SoaresCarlos/LCT_CARLOS/README.md

Laboratorio de Controle de Temperatura Portatil. Aqui encontram-se todos os codigos elaborados durante o desenvolvimento do projeto
