SoaresCarlos/LCT_CARLOS/Testes Experimentais/Testes_Only_python/Entrada Unitaria_900s.csv

Tempo (s) | PWM | Temperatura (ºC)
1.8605201244354248 | 127 | nan
2.9188530445098877 | 127 | 33.57771260997067
4.012604475021362 | 127 | 33.57771260997067
5.0719499588012695 | 127 | 33.57771260997067
6.132680177688599 | 127 | 33.57771260997067
7.197888135910034 | 127 | 33.57771260997067
8.24724006652832 | 127 | 33.57771260997067
9.29603362083435 | 127 | 33.57771260997067
10.345612287521362 | 127 | 33.57771260997067
11.41071629524231 | 127 | 33.57771260997067
12.459674835205078 | 127 | 33.57771260997067
13.51298451423645 | 127 | 34.066471163245346
14.574063062667847 | 127 | 33.57771260997067
15.623172998428345 | 127 | 34.066471163245346
16.672223806381226 | 127 | 34.066471163245346
17.737772703170776 | 127 | 34.55522971652003
18.786836862564087 | 127 | 34.55522971652003
19.836678981781006 | 127 | 34.55522971652003
20.88492774963379 | 127 | 35.04398826979471
21.93393063545227 | 127 | 35.04398826979471
22.9828462600708 | 127 | 35.04398826979471
24.031705617904663 | 127 | 35.04398826979471
25.080708265304565 | 127 | 35.04398826979471
26.13065457344055 | 127 | 35.04398826979471
27.195461750030518 | 127 | 35.04398826979471
28.244350910186768 | 127 | 35.04398826979471
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
