SoaresCarlos/LCT_CARLOS/Testes Experimentais/Testes_Only_python/Entrada Unitaria_900s_filtra.csv

Tempo (s) | PWM | Temperatura (ºC)
1 | 127 | 0
2 | 127 | 0
3 | 127 | 0
4 | 127 | 0
5 | 127 | 0
6 | 127 | 0
7 | 127 | 0
8 | 127 | 0
9 | 127 | 0
10 | 127 | 0
11 | 127 | 0
12 | 127 | 0
14 | 127 | 0.488758553
15 | 127 | 0
16 | 127 | 0.488758553
17 | 127 | 0.488758553
18 | 127 | 0.977517107
19 | 127 | 0.977517107
20 | 127 | 0.977517107
21 | 127 | 1.46627566
22 | 127 | 1.46627566
23 | 127 | 1.46627566
24 | 127 | 1.46627566
25 | 127 | 1.46627566
26 | 127 | 1.46627566
27 | 127 | 1.46627566
28 | 127 | 1.46627566
29 | 127 | 1.955034213
30 | 127 | 1.955034213
31 | 127 | 1.955034213
32 | 127 | 1.955034213
33 | 127 | 2.443792766
35 | 127 | 2.443792766
36 | 127 | 1.955034213
37 | 127 | 1.955034213
38 | 127 | 2.93255132
39 | 127 | 2.443792766
40 | 127 | 2.93255132
41 | 127 | 2.93255132
42 | 127 | 2.93255132
43 | 127 | 3.421309873
44 | 127 | 3.421309873
45 | 127 | 3.910068426
46 | 127 | 3.910068426
47 | 127 | 3.910068426
48 | 127 | 3.910068426
49 | 127 | 3.421309873
50 | 127 | 4.398826979
51 | 127 | 4.398826979
52 | 127 | 3.910068426
53 | 127 | 4.398826979
55 | 127 | 4.398826979
56 | 127 | 4.887585533
57 | 127 | 4.887585533
58 | 127 | 5.376344086
59 | 127 | 5.376344086
60 | 127 | 5.376344086
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
