SoaresCarlos/LCT_CARLOS/Testes Experimentais/Testes_Only_python/dados_temperatura_PI.csv

Tempo (s) | Amostra | PWM | Temperatura (°C)
2.01 | 2 | 38 | 36.02
3.28 | 3 | 40 | 35.53
4.41 | 4 | 41 | 35.53
5.56 | 5 | 40 | 36.02
6.71 | 6 | 42 | 35.53
7.85 | 7 | 43 | 35.53
9.01 | 8 | 42 | 36.02
10.13 | 9 | 44 | 35.53
11.31 | 10 | 45 | 35.53
12.46 | 11 | 46 | 35.53
13.61 | 12 | 46 | 35.53
14.77 | 13 | 47 | 35.53
15.92 | 14 | 48 | 35.53
17.07 | 15 | 47 | 36.02
18.22 | 16 | 48 | 36.02
19.37 | 17 | 50 | 35.53
20.52 | 18 | 49 | 36.02
21.67 | 19 | 50 | 36.02
22.81 | 20 | 52 | 35.53
23.96 | 21 | 52 | 36.02
25.13 | 22 | 54 | 35.53
26.28 | 23 | 54 | 35.53
27.43 | 24 | 54 | 36.02
28.58 | 25 | 56 | 35.53
29.72 | 26 | 55 | 36.02
30.87 | 27 | 57 | 35.53
32.02 | 28 | 58 | 35.53
33.17 | 29 | 57 | 36.02
34.34 | 30 | 59 | 35.53
35.50 | 31 | 59 | 36.02
36.67 | 32 | 61 | 35.53
37.82 | 33 | 61 | 35.53
38.98 | 34 | 62 | 35.53
40.13 | 35 | 63 | 35.53
41.28 | 36 | 64 | 35.53
42.44 | 37 | 64 | 35.53
43.63 | 38 | 64 | 36.02
44.78 | 39 | 64 | 36.02
45.93 | 40 | 65 | 36.02
47.07 | 41 | 67 | 35.53
48.22 | 42 | 67 | 36.02
49.37 | 43 | 67 | 36.02
50.52 | 44 | 68 | 36.02
51.67 | 45 | 69 | 36.02
52.82 | 46 | 69 | 36.02
53.98 | 47 | 70 | 36.02
55.13 | 48 | 71 | 36.02
56.28 | 49 | 73 | 35.53
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
