SoaresCarlos/LCT_CARLOS/Testes Experimentais/Testes_Only_python/dados_temperatura_PI40.csv

Tempo (s) | Amostra | PWM | Temperatura (°C)
2.02 | 2 | 28 | 29.67
3.20 | 3 | 28 | 29.67
4.60 | 4 | 29 | 29.67
5.75 | 5 | 28 | 30.16
6.92 | 6 | 31 | 29.18
8.08 | 7 | 32 | 29.18
9.26 | 8 | 31 | 29.67
10.43 | 9 | 30 | 30.16
11.60 | 10 | 29 | 30.65
12.78 | 11 | 33 | 29.67
13.96 | 12 | 32 | 30.16
15.11 | 13 | 29 | 31.13
16.29 | 14 | 33 | 30.16
19.42 | 15 | 33 | 30.16
20.64 | 16 | 34 | 30.16
21.82 | 17 | 33 | 30.65
23.00 | 18 | 37 | 29.18
24.18 | 19 | 36 | 29.67
25.37 | 20 | 38 | 29.18
26.55 | 21 | 35 | 30.65
27.71 | 22 | 38 | 29.67
28.91 | 23 | 37 | 30.16
30.09 | 24 | 39 | 29.67
31.28 | 25 | 38 | 30.16
32.46 | 26 | 40 | 29.67
33.64 | 27 | 41 | 29.67
34.88 | 28 | 38 | 30.65
36.05 | 29 | 41 | 29.67
37.21 | 30 | 41 | 30.16
38.41 | 31 | 40 | 30.65
39.64 | 32 | 39 | 31.13
40.82 | 33 | 39 | 31.13
42.01 | 34 | 41 | 30.65
43.20 | 35 | 40 | 31.13
44.36 | 36 | 41 | 31.13
45.52 | 37 | 43 | 30.65
46.70 | 38 | 42 | 31.13
47.89 | 39 | 45 | 30.16
49.06 | 40 | 44 | 30.65
50.25 | 41 | 44 | 30.65
51.42 | 42 | 45 | 30.65
52.61 | 43 | 45 | 30.65
53.79 | 44 | 46 | 30.65
54.96 | 45 | 42 | 32.11
56.16 | 46 | 44 | 31.62
57.35 | 47 | 47 | 30.65
58.52 | 48 | 48 | 30.65
59.72 | 49 | 48 | 30.65
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
