SoaresCarlos/LCT_CARLOS/Testes Experimentais/Testes_Only_python/dados_temperatura_PI40_filtro.csv

Tempo (s) | Amostra | PWM | Temperatura (°C)
2.02 | 2 | 28 | 0
3.2 | 3 | 28 | 0
4.6 | 4 | 29 | 0
5.75 | 5 | 28 | 0.489999999999998
6.92 | 6 | 31 | -0.490000000000002
8.08 | 7 | 32 | -0.490000000000002
9.26 | 8 | 31 | 0
10.43 | 9 | 30 | 0.489999999999998
11.6 | 10 | 29 | 0.979999999999997
12.78 | 11 | 33 | 0
13.96 | 12 | 32 | 0.489999999999998
15.11 | 13 | 29 | 1.46
16.29 | 14 | 33 | 0.489999999999998
19.42 | 15 | 33 | 0.489999999999998
20.64 | 16 | 34 | 0.489999999999998
21.82 | 17 | 33 | 0.979999999999997
23 | 18 | 37 | -0.490000000000002
24.18 | 19 | 36 | 0
25.37 | 20 | 38 | -0.490000000000002
26.55 | 21 | 35 | 0.979999999999997
27.71 | 22 | 38 | 0
28.91 | 23 | 37 | 0.489999999999998
30.09 | 24 | 39 | 0
31.28 | 25 | 38 | 0.489999999999998
32.46 | 26 | 40 | 0
33.64 | 27 | 41 | 0
34.88 | 28 | 38 | 0.979999999999997
36.05 | 29 | 41 | 0
37.21 | 30 | 41 | 0.489999999999998
38.41 | 31 | 40 | 0.979999999999997
39.64 | 32 | 39 | 1.46
40.82 | 33 | 39 | 1.46
42.01 | 34 | 41 | 0.979999999999997
43.2 | 35 | 40 | 1.46
44.36 | 36 | 41 | 1.46
45.52 | 37 | 43 | 0.979999999999997
46.7 | 38 | 42 | 1.46
47.89 | 39 | 45 | 0.489999999999998
49.06 | 40 | 44 | 0.979999999999997
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
