SoaresCarlos/LCT_CARLOS/Testes Experimentais/Testes_Only_python/PI_teste 02.png

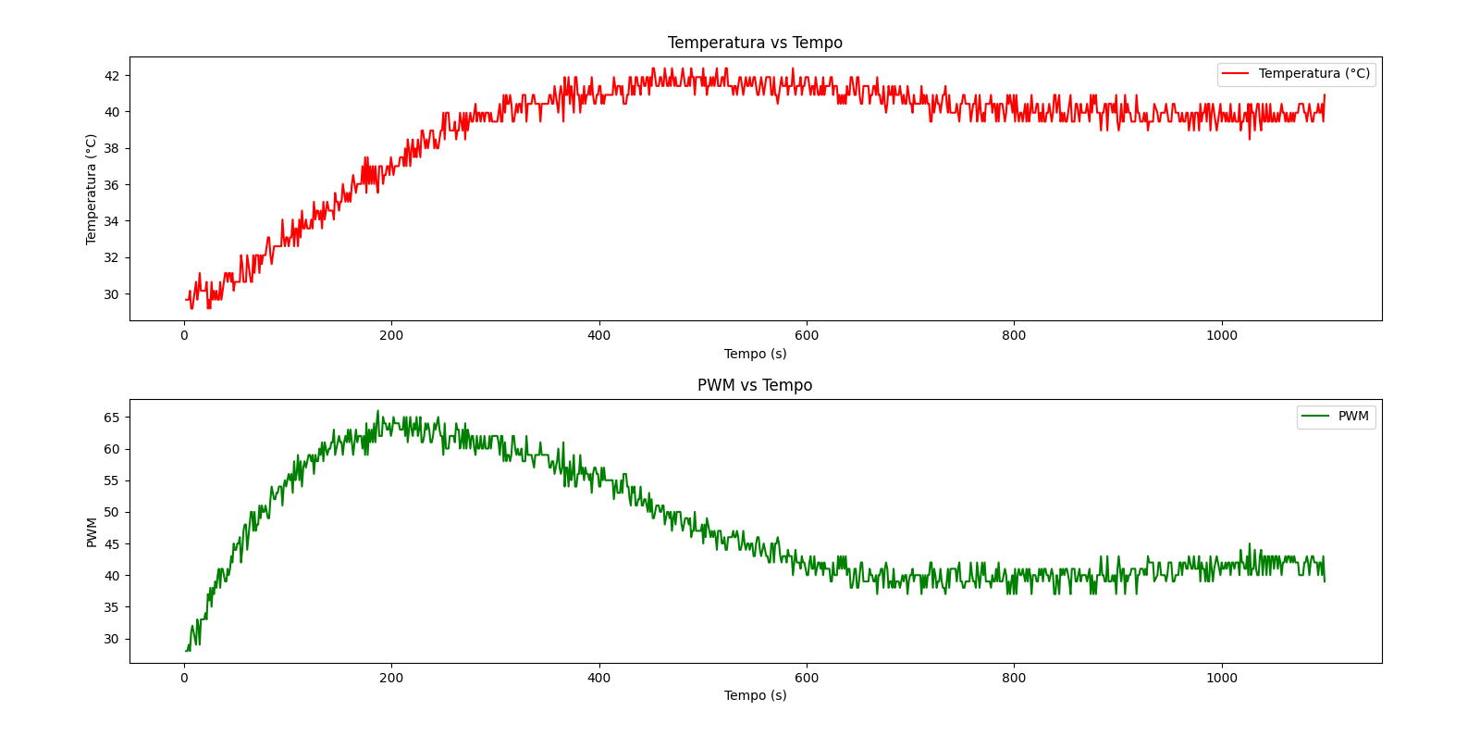
Testes Experimentais/Testes_Only_python/PI_teste 02.png
