SoaresCarlos/LCT_CARLOS/(commit log)

2024-10-25 Arquivos Only Python_LCT
    Contem os codigos onde o arduino funciona somente como um servo e toda a a modelagem é realizada dentro do ambiente em python.
2024-10-25 Testes experimentais
    Testes realizados com o sistema fisico do LCT para coleta de dados.
    [Entrada Unitaria_900s.csv, Entrada Unitaria_900s_filtra.csv, dados.csv, dados_temperatura_PI.csv, dados_temperatura_PI40.csv, dados_temperatura_PI40_filtro.csv, dados_temperatura_PI_SP50.csv, dados_temperatura_PI_SP50_filtro.csv]
2024-11-01 Avaliação de Sistemas de Controle I
    Relatorios e codigos (Python e Arduino) feitos para a 3ª avaliação da materia de sistemas de Controle I pelos alunos:
    Carlos Soares Costa Junior – 202233940020
    Jessica da Silva Sousa - 202233940008
